lancepitka/Espresso-HX-PID/firmware/README.md

# STM32 Firmware for Espresso Controller

TODO

# Required Software

- STM32CubeMX
- STM32CubeCLT
- Clang Format

## Recommended VS Code Extensions

- stm32CubeCore
- Serial Monitor
- Git Graph
- CMake Tools
- Clang-Format
- C/C++ Extension Pack
