lancepitka/Espresso-HX-PID/firmware/Core/Src/app/sh1106/readme.md

# SH1106 Driver

Driver from https://controllerstech.com/interface-sh1106-oled-display-with-stm32/
