lancepitka/Espresso-HX-PID/FreeCAD/button.stp

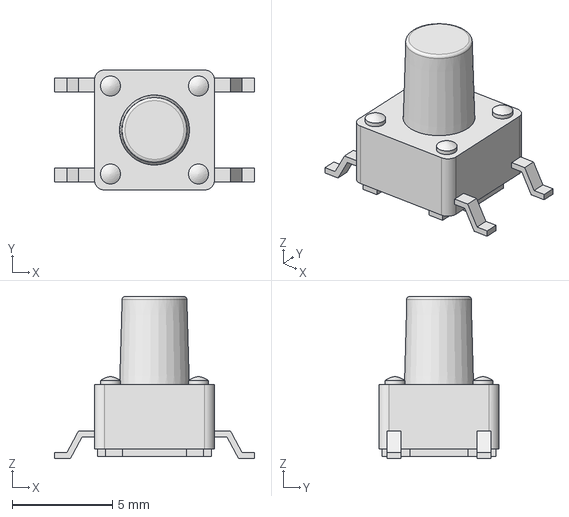
[picture p1: CAD file, 2026-05-21]
FreeCAD/button.stp
10.00 x 6.00 x 8.10 mm
