lancepitka/Espresso-HX-PID/FreeCAD/OLED/HS13L03W2C01.step

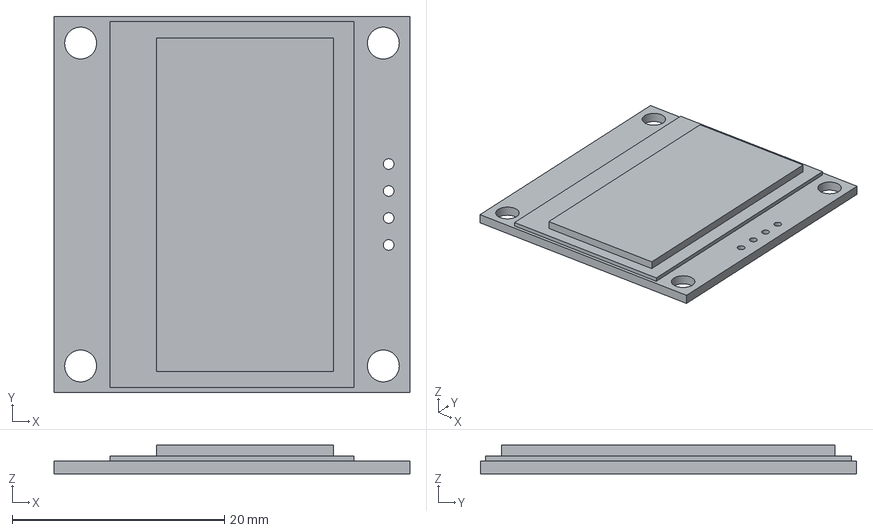
[picture p2: CAD file, 2026-05-21]
FreeCAD/OLED/HS13L03W2C01.step
33.5 x 35.4 x 2.70 mm
