lancepitka/Espresso-HX-PID/FreeCAD/Standoffs/SMTSO2540CTJ.step

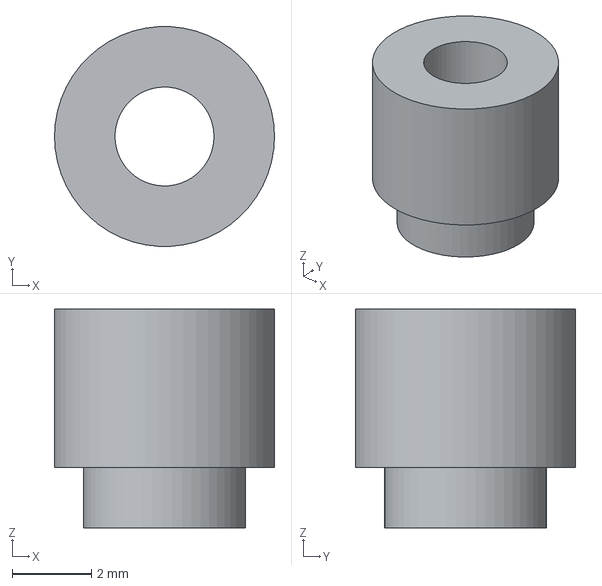
[picture p3: CAD file, 2026-05-21]
FreeCAD/Standoffs/SMTSO2540CTJ.step
5.56 x 5.55 x 5.53 mm
