lancepitka/Espresso-HX-PID/(list of files, cad)

Other CAD files:
FreeCAD/OLED/Unnamed.FCStd
FreeCAD/OLED/HS13L03W2C01.FCStd
FreeCAD/Standoffs/SMTSO2540CTJ.FCStd
