lancepitka/Espresso-HX-PID/PCB/RocketPressurePID.kicad_pcb

## KiCad design PCB/RocketPressurePID.kicad_pcb (2026-06-02)

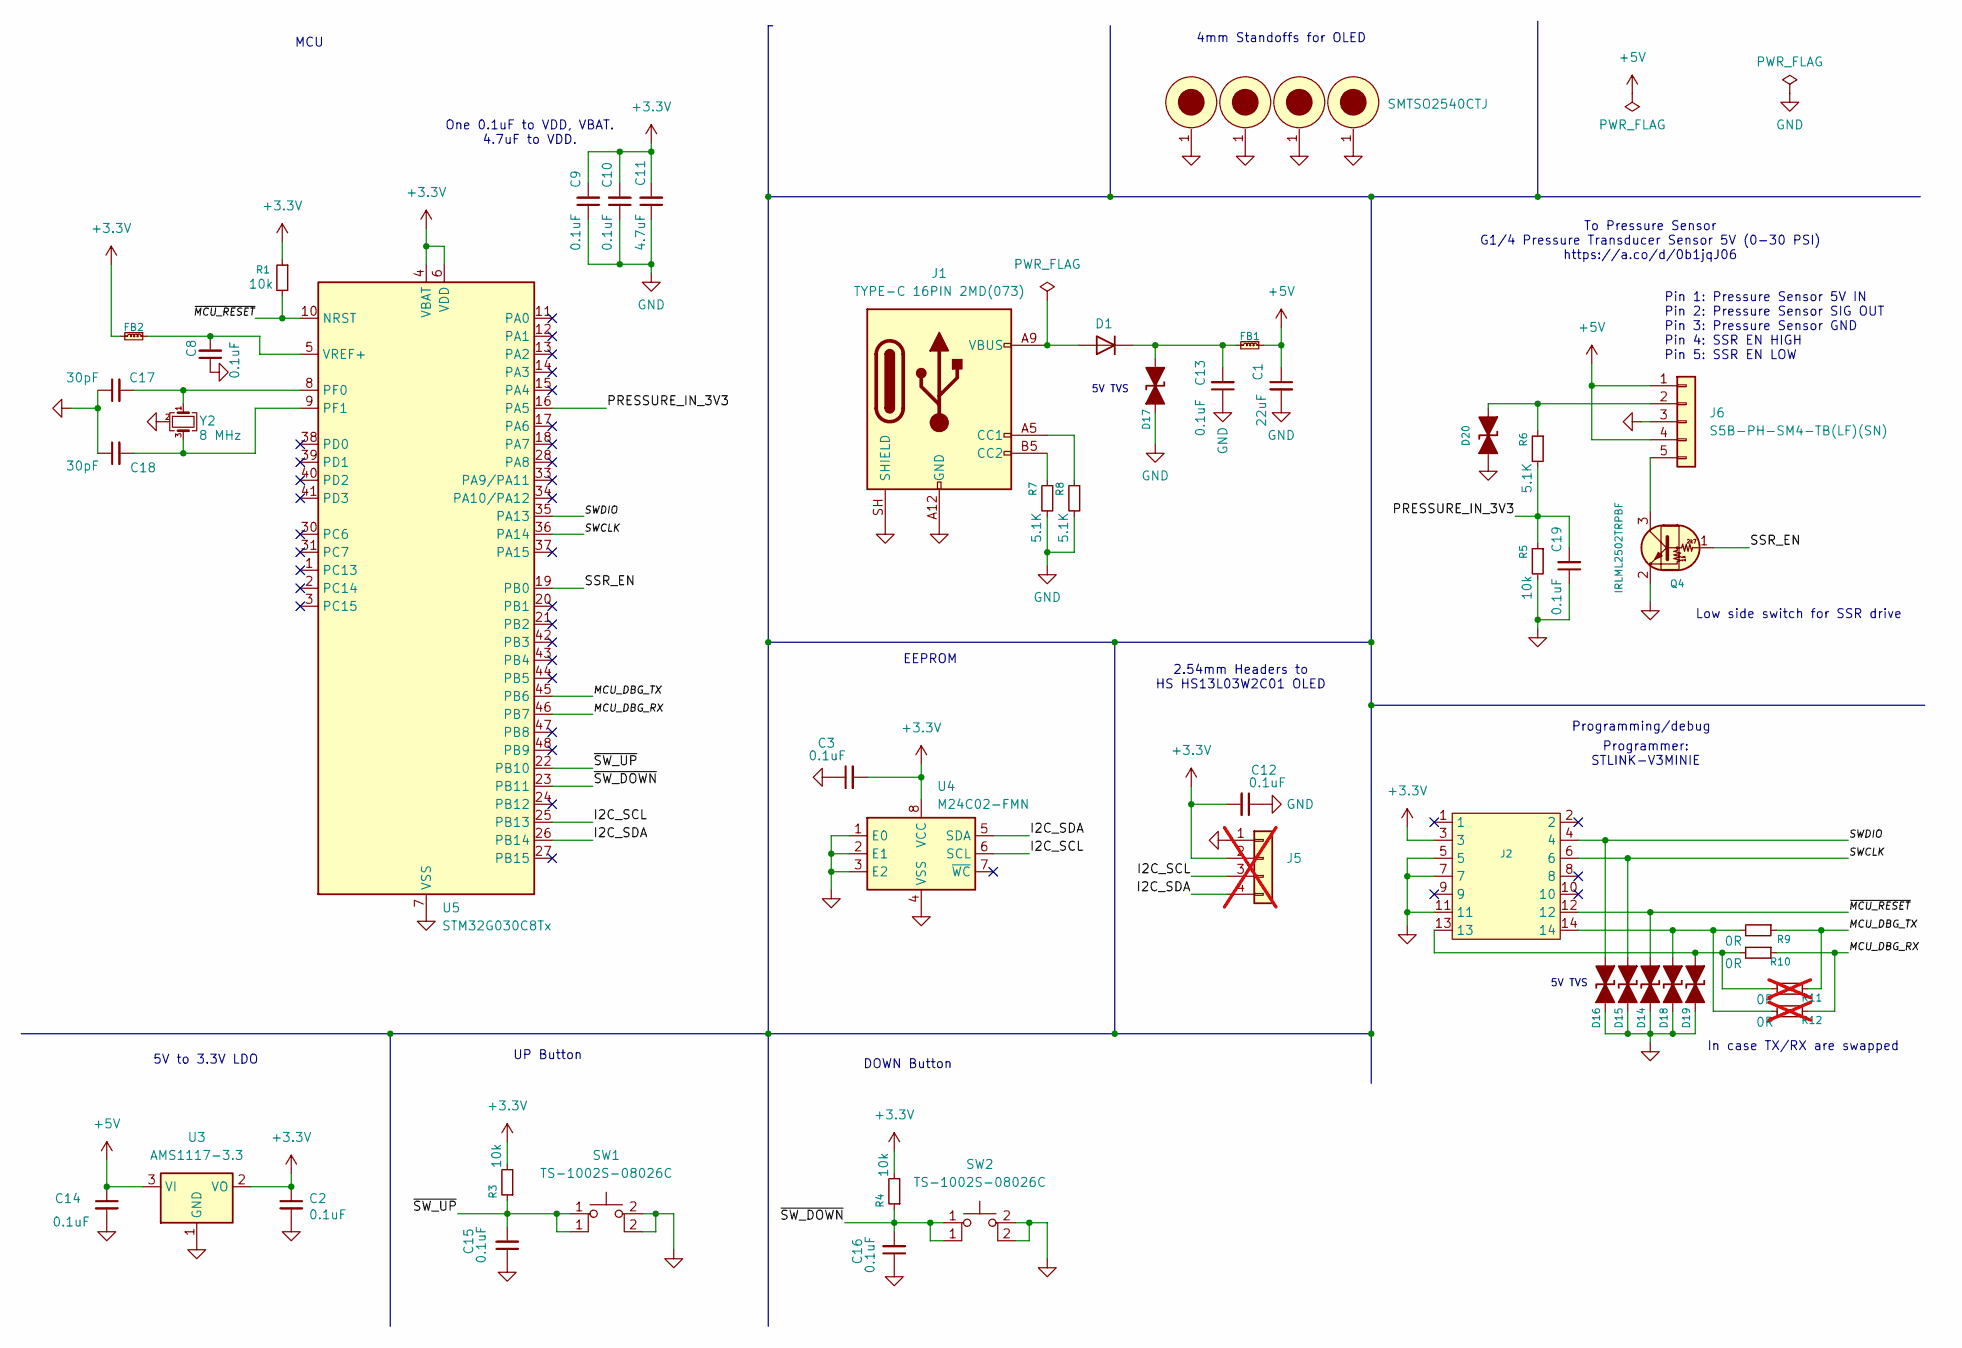
[picture p4: schematic RocketPressurePID.kicad_sch, Rocket HX Pressure Controller]

Parts:
C1: 22uF; C_0603_1608Metric; LCSC C59461
C2, C3, C8, C9, C10, C12, C13, C14, C15, C16, C19: 0.1uF; C_0603_1608Metric; LCSC C14663
C11: 4.7uF; C_0603_1608Metric; LCSC C19666
C17, C18: 30pF; C_0603_1608Metric; LCSC C1658
D1: Nexperia_CFP3_SOD-123W; LCSC C8598
D14, D15, D16, D17, D18, D19, D20: 5V_TVS; D_SOD-323; LCSC C2835457
FB1, FB2: BLM18PG330SN1D; L_0603_1608Metric; Part Number BLM18PG330SN1D; LCSC C1002
J1: TYPE-C 16PIN 2MD(073); USB_C_Receptacle_GCT_USB4105-xx-A_16P_TopMnt_Horizontal; LCSC C2765186
J2: 2x14 1.27mm SMD; PinHeader_2x07_P1.27mm_Vertical_SMD; LCSC C41376039
J5: PinHeader_1x04_P2.54mm_Vertical; LCSC C2691448; not fitted
J6: S5B-PH-SM4-TB(LF)(SN); JST_PH_S5B-PH-SM4-TB_1x05-1MP_P2.00mm_Horizontal; LCSC C265104
Q4: IRLML2502TRPBF; SOT-23; Part Number IRLML2502TRPBF; LCSC C2589
R1, R3, R4, R5: 10k; R_0603_1608Metric; LCSC C25804
R6, R7, R8: 5.1K; R_0603_1608Metric; LCSC C23186
R9, R10: 0R; R_0603_1608Metric; LCSC C21189
R11, R12: 0R; R_0603_1608Metric; LCSC C21189; not fitted
STD1, STD2, STD3, STD4: SMTSO2540CTJ; standoff_SMTSO2540CTJ; LCSC C2916324
SW1, SW2: TS-1002S-08026C; SW_SPST_PTS645Sx43SMTR92; LCSC C455116
U3: AMS1117-3.3; SOT-223-3_TabPin2; LCSC C6186
U4: M24C02-FMN; SOIC-8_3.9x4.9mm_P1.27mm
U5: STM32G030C8Tx; LQFP-48_7x7mm_P0.5mm; LCSC C529329
Y2: 8 MHz; Crystal_SMD_3225-4Pin_3.2x2.5mm; LCSC C2682774

Connections:
+3.3V: C2.1, C3.2, C9.2, C10.2, C11.2, C12.2, FB2.2, J2.3, J5.2, R1.1, R3.2, R4.2, U3.2 (VO), U4.8 (VCC), U5.4 (VBAT), U5.6 (VDD)
+5V: C1.1, C14.1, FB1.1, J6.1, J6.4, U3.3 (VI)
/I2C_SCL: J5.3, U4.6 (SCL), U5.25 (PB13)
/I2C_SDA: J5.4, U4.5 (SDA), U5.26 (PB14)
/MCU_DBG_RX: R10.1, R12.1, U5.46 (PB7)
/MCU_DBG_TX: R9.1, R11.1, U5.45 (PB6)
/PRESSURE_IN_3V3: C19.2, R5.1, R6.2, U5.16 (PA5)
/SSR_EN: Q4.1 (B), U5.19 (PB0)
/SWCLK: D15.1 (A1), J2.6, U5.36 (PA14)
/SWDIO: D16.1 (A1), J2.4, U5.35 (PA13)
/~MCU_RESET: D14.1 (A1), J2.12, R1.2, U5.10 (NRST)
/~SW_DOWN: C16.2, R4.1, SW2.1, U5.23 (PB11)
/~SW_UP: C15.2, R3.1, SW1.1, U5.22 (PB10)
GND: C1.2, C2.2, C3.1, C8.1, C9.1, C10.1, C11.1, C12.1, C13.1, C14.2, C15.1, C16.1, C17.1, C18.1, C19.1, D14.2 (A2), D15.2 (A2), D16.2 (A2), D17.2 (A2), D18.2 (A2), D19.2 (A2), D20.2 (A2), J1.A1 (GND), J1.A12 (GND), J1.B1 (GND), J1.B12 (GND), J1.SH (SHIELD), J2.5, J2.7, J2.11, J5.1, J6.3, Q4.2 (E), R5.2, R7.2, R8.2, STD1.1, STD2.1, STD3.1, STD4.1, SW1.2, SW2.2, U3.1 (GND), U4.1 (E0), U4.2 (E1), U4.3 (E2), U4.4 (VSS), U5.7 (VSS), Y2.2 (G), Y2.4 (G)
unnamed: D1.2 (A), J1.A4 (VBUS), J1.A9 (VBUS), J1.B4 (VBUS), J1.B9 (VBUS)
unnamed: C13.2, D1.1 (K), D17.1 (A1), FB1.2
unnamed: D18.1 (A1), J2.14, R9.2, R12.2
unnamed: D19.1 (A1), J2.13, R10.2, R11.2
unnamed: D20.1 (A1), J6.2, R6.1
unnamed: J1.A5 (CC1), R8.1
unnamed: J1.B5 (CC2), R7.1
unnamed: J6.5, Q4.3 (C)
unnamed: C17.2, U5.8 (PF0), Y2.1
unnamed: C18.2, U5.9 (PF1), Y2.3
unnamed: C8.2, FB2.1, U5.5 (VREF+)

Notes on the sheet:
UP Button
2.54mm Headers to HS HS13L03W2C01 OLED
One 0.1uF to VDD, VBAT. 4.7uF to VDD.
5V to 3.3V LDO
Pin 1: Pressure Sensor 5V IN Pin 2: Pressure Sensor SIG OUT Pin 3: Pressure Sensor GND Pin 4: SSR EN HIGH Pin 5: SSR EN LOW
5V TVS
DOWN Button
Programming/debug
In case TX/RX are swapped
4mm Standoffs for OLED
Low side switch for SSR drive
MCU
EEPROM
Programmer: STLINK-V3MINIE
To Pressure Sensor G1/4 Pressure Transducer Sensor 5V (0-30 PSI) https://a.co/d/0b1jqJ06

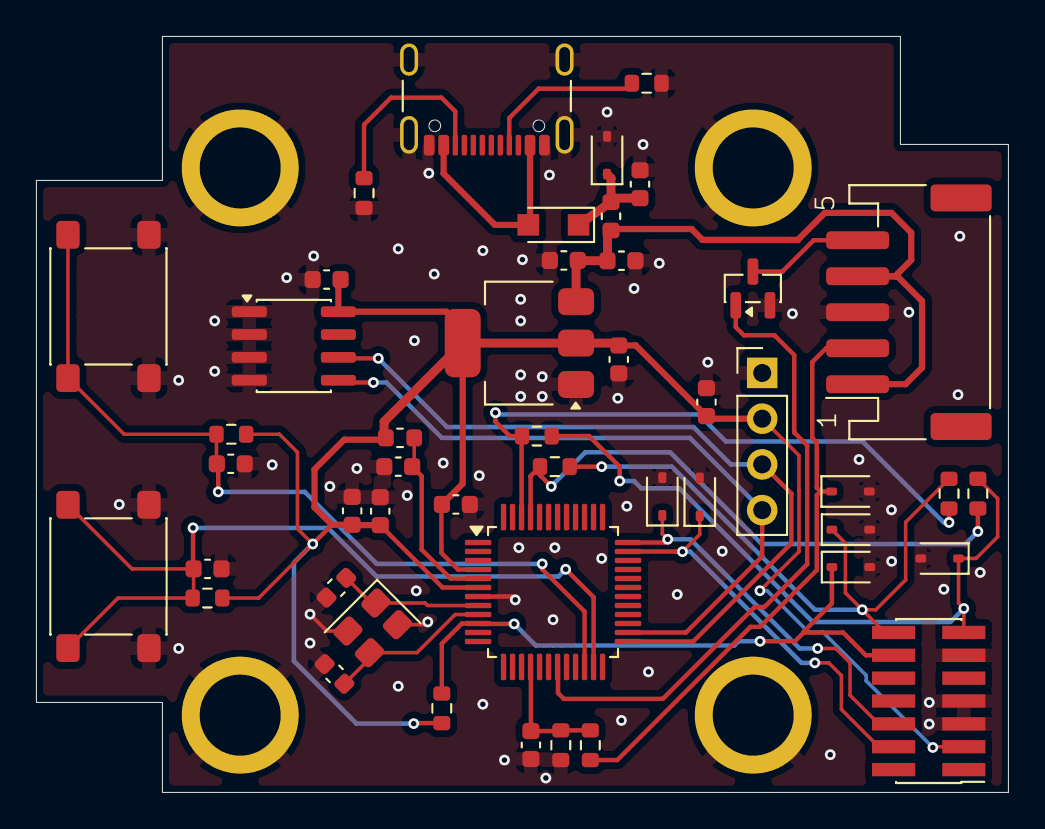
[picture p5: board RocketPressurePID.kicad_pcb from above]

Board: 2 copper layers, 54.0 x 42.0 mm, 52 parts (0 on the bottom side), 25 nets.

Other parts of the board:
U2: HS HS13L03W2C01; HS13L03W2C01
