lancepitka/Espresso-HX-PID/firmware/espresso-pressure-pid.ioc

Mcu.UserName=STM32G030C8Tx
PA13.Signal=SYS_SWDIO
PA14-BOOT0.Signal=SYS_SWCLK
PA5.Signal=ADC1_IN5
PB0.GPIO_Label=SSR_EN
PB0.Signal=GPIO_Output
PB10.GPIO_Label=nSW_UP
PB10.Signal=GPIO_Input
PB11.GPIO_Label=nSW_DOWN
PB11.Signal=GPIO_Input
PB13.Signal=I2C2_SCL
PB14.Signal=I2C2_SDA
PB6.Signal=USART1_TX
PB7.Signal=USART1_RX
