lancepitka/Espresso-HX-PID/firmware/Core/Inc/main.h

#define SSR_EN_Pin GPIO_PIN_0
#define SSR_EN_GPIO_Port GPIOB
#define nSW_UP_Pin GPIO_PIN_10
#define nSW_UP_GPIO_Port GPIOB
#define nSW_DOWN_Pin GPIO_PIN_11
#define nSW_DOWN_GPIO_Port GPIOB
