lancepitka/Espresso-HX-PID/(commit log)

2026-06-02 v1.0 manufacturing
    [RocketPressurePID.kicad_pcb, RocketPressurePID.kicad_sch, bom.csv, designators.csv, positions.csv]
2026-06-10 Added timer
2026-06-10 Updated ADC to continuous conversion mode, 16x over sample ratio (effective 14 bit)
2026-06-18 Got ADC setup and reading properly
2026-06-18 Added adc read api
2026-06-19 Updated alt part number
    [RocketPressurePID.kicad_sch]
2026-06-19 Added ADC filtering
2026-06-19 Implemented button driver
2026-06-19 Added SH1106 driver code
